Mattkomi/IHM_CNC/Besoin.xlsx

Sheet: Feuil1
Nom | Quantité | Coût | Fabricant | Numéro | Lien
Relai | 8 |  | American Zettler | AZ943-1CH-12DE | https://www.digikey.ca/fr/products/detail/american-zettler/AZ943-1CH-12DE/12171590
Relai double | 2 |  | American Zettler | AZ733-2CE-12DE | https://www.digikey.ca/fr/products/detail/american-zettler/AZ733-2CE-12DE/14307609
LED Blanche | 4 |  | QT Brightek (QTB) | QBL8IW40D-CW | https://www.digikey.ca/fr/products/detail/qt-brightek-qtb/QBL8IW40D-CW/10441179
LED RGB | 6 |  | QT Brightek (QTB) | QBL8RGB60D0-2897 | https://www.digikey.ca/fr/products/detail/qt-brightek-qtb/QBL8RGB60D0-2897/10441184
Switch | 8 |  | E-Switch | RB141C1100 | https://www.digikey.ca/fr/products/detail/e-switch/RB141C1100/3778081
Buzzer | 1 |  | Soberton Inc. | WT-1205 | https://www.digikey.ca/fr/products/detail/soberton-inc/WT-1205/479674
ESP32 | 1 |  | Espressif Systems | ESP32-DEVKITM-1 | https://www.digikey.ca/fr/products/detail/espressif-systems/ESP32-DEVKITM-1/13532113
Régulateur tension | 1 |  | Texas Instruments | LM2596S-5.0 | https://www.digikey.ca/fr/products/detail/texas-instruments/lm2596s-5-0/3701226
Ventilateur | 1 |  | Sunon Fans | HA40201V4-1000U-A99 | https://www.digikey.ca/fr/products/detail/sunon-fans/HA40201V4-1000U-A99/6198729
Capteur de flamme | 1 |  | Soldered Electronics | 333047 | https://www.digikey.ca/fr/products/detail/soldered-electronics/333047/21720425
Capteur de température Water | 2 |  | DFRobot | DFR0198 | https://www.digikey.ca/fr/products/detail/dfrobot/DFR0198/7597054
Capteur de température | 1 |  | Analog Devices Inc. | TMP36GT9Z | https://www.digikey.ca/fr/products/detail/analog-devices-inc/TMP36GT9Z/820404
Transistor | 15 |  | Diotec Semiconductor | BC337-16 | https://www.digikey.ca/fr/products/detail/diotec-semiconductor/BC337-16/22191949
Connecteur Embase | 3 |  | Harwin Inc. | M20-7822046 | https://www.digikey.ca/fr/products/detail/harwin-inc/m20-7822046/3727872
Switch Alimentation | 1 |  | E-Switch | RA1113112R | https://www.digikey.ca/fr/products/detail/e-switch/RA1113112R/3778055
Capteur humidité + température | 1 |  | Seeed Technology Co., Ltd | 101020011 | https://www.digikey.ca/fr/products/detail/seeed-technology-co-ltd/101020011/5482602
Ecran OLED | 1 |  | Newhaven Display Intl | NHD-2.7-12864WDW3 | https://www.digikey.ca/fr/products/detail/newhaven-display-intl/nhd-2-7-12864wdw3/7355953
Extender GPIO | 5 |  | Microchip Technology | MCP23017-E/SO | https://www.digikey.ca/fr/products/detail/microchip-technology/mcp23017-e-so/894271
Extender GPIO | 5 |  | NXP USA Inc. | PCA9685PW,112 | https://www.digikey.ca/fr/products/detail/nxp-usa-inc/pca9685pw-112/2034324
Level Shifter | 3 |  | Texas Instruments | TXS0104ED | https://www.digikey.ca/fr/products/detail/texas-instruments/txs0104ed/1910175
Conn JST DROIT Male 2pin | 16 |  | JST Sales America Inc. | B2B-XH-A | https://www.digikey.ca/fr/products/detail/jst-sales-america-inc/B2B-XH-A/1651045
Conn JST 90deg male 2pin | 3 |  | JST Sales America Inc. | S2B-XH-A-1 | https://www.digikey.ca/fr/products/detail/jst-sales-america-inc/S2B-XH-A-1/9961922
Conn JST femelle 2pin | 20 |  | JST Sales America Inc. | XHP-2 | https://www.digikey.ca/fr/products/detail/jst-sales-america-inc/XHP-2/555485
Conn JST Male 20pin | 2 |  | JST Sales America Inc. | B20B-XH-A(LF)(SN) | https://www.digikey.ca/fr/products/detail/jst-sales-america-inc/B20B-XH-A-LF-SN/3677009
Conn JST Femelle 20pin | 2 |  | JST Sales America Inc. | XHP-20 | https://www.digikey.ca/fr/products/detail/jst-sales-america-inc/XHP-20/1651009
Conn JST 90deg male 3pin | 6 |  | JST Sales America Inc. | S3B-XH-A | https://www.digikey.ca/fr/products/detail/jst-sales-america-inc/S3B-XH-A/1651048
Conn JST femelle 3pin | 10 |  | JST Sales America Inc. | XHP-3 | https://www.digikey.ca/fr/products/detail/jst-sales-america-inc/XHP-3/1651017
Conn JST male 4pin | 6 |  | JST Sales America Inc. | B4B-XH-A | https://www.digikey.ca/fr/products/detail/jst-sales-america-inc/B4B-XH-A/1651047
Conn JST femelle 4pin | 10 |  | JST Sales America Inc. | XHP-4 | https://www.digikey.ca/fr/products/detail/jst-sales-america-inc/xhp-4/683353
Contact JST XH | 100 |  | JST Sales America Inc. | SXH-002T-P0.6 | https://www.digikey.ca/fr/products/detail/jst-sales-america-inc/SXH-002T-P0-6/1651063
Conn Molex Male 2pin | 10 |  | Molex | 430450200 | https://www.digikey.ca/fr/products/detail/molex/0430450200/252526
Conn Molex femelle 2pin | 10 |  | Molex | 430250200 | https://www.digikey.ca/fr/products/detail/molex/0430250200/252496
Contact Molex microfit | 100 |  | Molex | 430300038 | https://www.digikey.ca/fr/products/detail/molex/0430300038/6098601
Resistance 10k Ohm CMS | 10 |  | YAGEO | RC1206FR-0710KL | https://www.digikey.ca/fr/products/detail/yageo/RC1206FR-0710KL/728483
Resistance 1,6k Ohm CMS | 10 |  | YAGEO | RC1206FR-071K6L | https://www.digikey.ca/fr/products/detail/yageo/RC1206FR-071K6L/728450
Resistance 1,3k Ohm CMS | 10 |  | YAGEO | RC1206FR-071K3L | https://www.digikey.ca/fr/products/detail/yageo/RC1206FR-071K3L/728423
Resistance 1k Ohm CMS | 10 |  | YAGEO | RC1206FR-071KL | https://www.digikey.ca/fr/products/detail/yageo/RC1206FR-071KL/728387
Resistance 4,7k Ohm CMS | 10 |  | YAGEO | RC1206FR-074K7L | https://www.digikey.ca/fr/products/detail/yageo/RC1206FR-074K7L/728887
Resistance 680 Ohm CMS | 15 |  | YAGEO | RC1206FR-07680RL | https://www.digikey.ca/fr/products/detail/yageo/RC1206FR-07680RL/729064
Resistance 330 Ohm CMS | 10 |  | YAGEO | RC1206FR-07330RL | https://www.digikey.ca/fr/products/detail/yageo/RC1206FR-07330RL/728822
Resistance 220 Ohm CMS | 10 |  | YAGEO | RC1206FR-07220RL | https://www.digikey.ca/fr/products/detail/yageo/RC1206FR-07220RL/728693
Resistance 120 Ohm CMS | 15 |  | YAGEO | RC1206FR-07120RL | https://www.digikey.ca/fr/products/detail/yageo/RC1206FR-07120RL/728523
Diode shockty | 15 |  | Diotec Semiconductor | 1N5821 | https://www.digikey.ca/fr/products/detail/diotec-semiconductor/1N5821/22193451
Condensateur 150µF | 2 |  | Panasonic Electronic Components | EEU-FR1E151 | https://www.digikey.ca/fr/products/detail/panasonic-electronic-components/EEU-FR1E151/2433548
Condensateur 330µF | 2 |  | Panasonic Electronic Components | EEU-FR1E331 | https://www.digikey.ca/fr/products/detail/panasonic-electronic-components/eeu-fr1e331/2433549
Inductance 68µH | 2 |  | Bourns Inc. | SRR1260-680M | https://www.digikey.ca/fr/products/detail/bourns-inc/SRR1260-680M/1969964
Condensateur 100nF | 10 |  | EPCOS - TDK Electronics | B32529C0104J289 | https://www.digikey.ca/fr/products/detail/epcos-tdk-electronics/B32529C0104J289/1089744
SW AU | 1 |  | APEM Inc. | YW1B-V4E01R | https://www.digikey.ca/fr/products/detail/apem-inc/YW1B-V4E01R/15216547
Alimentation | 1 |  | Qualtek | QFWB-36-12-US01 | https://www.digikey.ca/fr/products/detail/qualtek/QFWB-36-12-US01/8260131
Conn ALIM | 1 |  | MPD (Memory Protection Devices) | EJ502A | https://www.digikey.ca/fr/products/detail/mpd-memory-protection-devices/EJ502A/2439536
Ventilateur | 1 |  | Sunon Fans | MEC0251V3-000U-A99 | https://www.digikey.ca/fr/products/detail/sunon-fans/MEC0251V3-000U-A99/2021100
Tresse à dessouder | 1 |  | Techspray | 1811-5F | https://www.digikey.ca/fr/products/detail/techspray/1811-5F/7914502
FLUX | 1 |  | Chip Quik Inc. | NC191 | https://www.digikey.ca/fr/products/detail/chip-quik-inc/NC191/11480391
Etain | 1 |  | American Hakko Products, Inc. | 611-1 | https://www.digikey.ca/fr/products/detail/american-hakko-products-inc/611-1/6228764
Buzzer | 1 |  | Mallory Sonalert Products Inc. | PK-26N04W-03VQ | https://www.digikey.ca/fr/products/detail/mallory-sonalert-products-inc/PK-26N04W-03VQ/5033696

Sheet: Feuil2
Pompe
Tuyau
Petite grille
Seau / bac
Entretoise
insert
