Mattkomi/IHM_CNC/CAO/IHM_P1 v14.stl

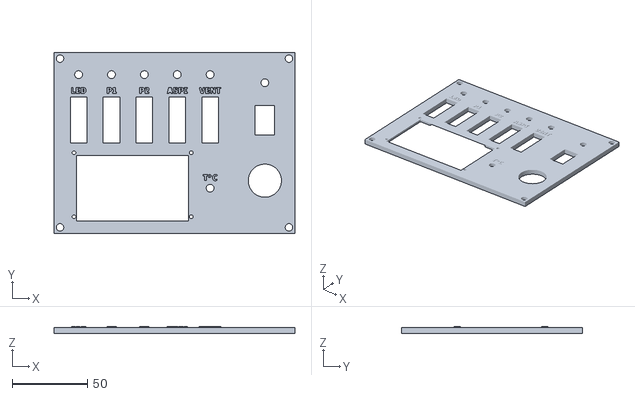
[picture p1: CAD file, 2025-04-13]
CAO/IHM_P1 v14.stl
160.0 x 120.0 x 4.50
