Mattkomi/IHM_CNC/PCB_control/PCB_control.kicad_pcb

## KiCad design PCB_control/PCB_control.kicad_pcb (2025-04-13)

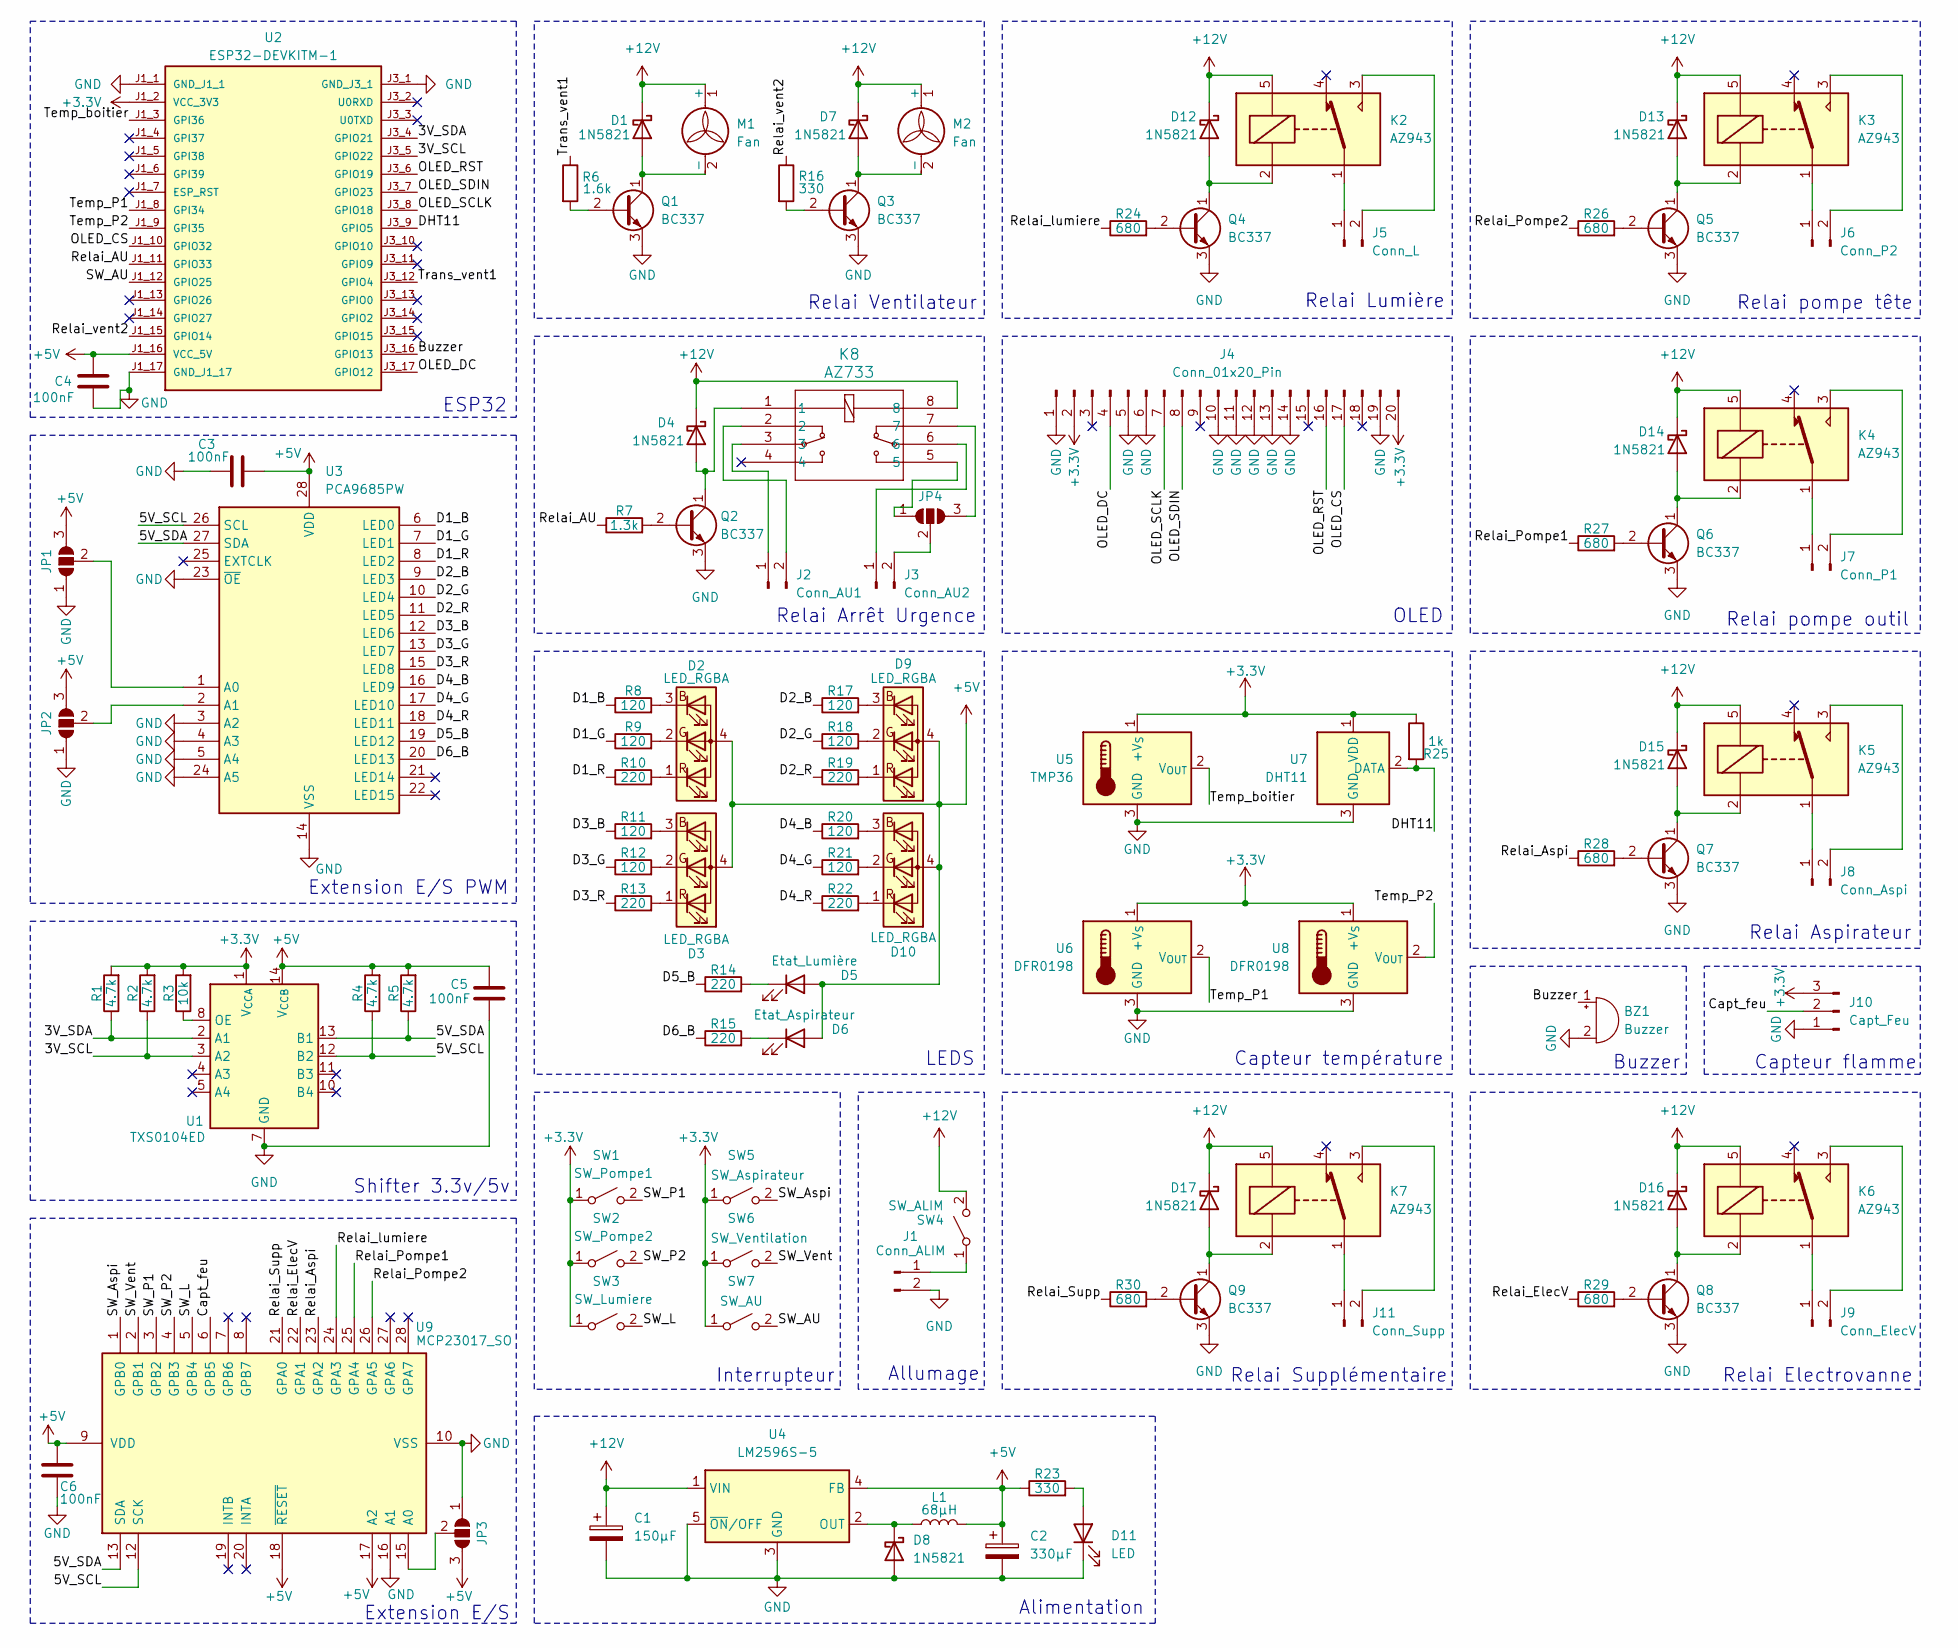
[picture p2: schematic PCB_control.kicad_sch, Schéma éléctronique IHM CNC]

Parts:
BZ1: Buzzer; WST-1205S
C1: 150µF; CP_Radial_D6.3mm_P2.50mm
C2: 330µF; CP_Radial_D8.0mm_P3.50mm
C3, C4, C5, C6: 100nF; CAP_R82D-7P4X2P6-5P0_KEM
D1, D4, D7, D8, D12, D13, D14, D15, D16, D17: 1N5821; P2_DO-201
D2, D3, D9, D10: LED_RGBA; JST_XH_B4B-XH-A_1x04_P2.50mm_Vertical
D5: Etat_Lumière; JST_XH_B2B-XH-A_1x02_P2.50mm_Vertical
D6: Etat_Aspirateur; JST_XH_B2B-XH-A_1x02_P2.50mm_Vertical
D11: LED; JST_XH_B2B-XH-A_1x02_P2.50mm_Vertical
J1: Conn_ALIM; JST_XH_B2B-XH-A_1x02_P2.50mm_Vertical
J2: Conn_AU1; Molex_Micro-Fit_3.0_43045-0200_2x01_P3.00mm_Horizontal
J3: Conn_AU2; Molex_Micro-Fit_3.0_43045-0200_2x01_P3.00mm_Horizontal
J4: Conn_01x20_Pin; JST_XH_B20B-XH-A_1x20_P2.50mm_Vertical
J5: Conn_L; Molex_Micro-Fit_3.0_43045-0200_2x01_P3.00mm_Horizontal
J6: Conn_P2; Molex_Micro-Fit_3.0_43045-0200_2x01_P3.00mm_Horizontal
J7: Conn_P1; Molex_Micro-Fit_3.0_43045-0200_2x01_P3.00mm_Horizontal
J8: Conn_Aspi; Molex_Micro-Fit_3.0_43045-0200_2x01_P3.00mm_Horizontal
J9: Conn_ElecV; Molex_Micro-Fit_3.0_43045-0200_2x01_P3.00mm_Horizontal
J10: Capt_Feu; JST_XH_S3B-XH-A_1x03_P2.50mm_Horizontal
J11: Conn_Supp; Molex_Micro-Fit_3.0_43045-0200_2x01_P3.00mm_Horizontal
JP1, JP2, JP3: SolderJumper_3_Open; SolderJumper-3_P1.3mm_Open_RoundedPad1.0x1.5mm
JP4: SolderJumper_3_Open; SolderJumper-3_P1.3mm_Open_RoundedPad1.0x1.5mm_NumberLabels
K2, K3, K4, K5, K6, K7: AZ943; AZ943-1CH_AMZ
K8: AZ733; AZ733-2C_AMZ
L1: 68µH; L_Bourns_SRR1260
M1: Fan; JST_XH_B2B-XH-A_1x02_P2.50mm_Vertical
M2: Fan; JST_XH_S2B-XH-A-1_1x02_P2.50mm_Horizontal
Q1, Q2, Q3, Q4, Q5, Q6, Q7, Q8, Q9: BC337; TO-92_Inline
R1, R2, R4, R5: 4.7k; R_1206_3216Metric_Pad1.30x1.75mm_HandSolder
R3: 10k; R_1206_3216Metric_Pad1.30x1.75mm_HandSolder
R6: 1.6k; R_1206_3216Metric_Pad1.30x1.75mm_HandSolder
R7: 1.3k; R_1206_3216Metric_Pad1.30x1.75mm_HandSolder
R8, R9, R11, R12, R17, R18, R20, R21: 120; R_1206_3216Metric_Pad1.30x1.75mm_HandSolder
R10, R13, R14, R15, R19, R22: 220; R_1206_3216Metric_Pad1.30x1.75mm_HandSolder
R16, R23: 330; R_1206_3216Metric_Pad1.30x1.75mm_HandSolder
R24, R26, R27, R28, R29, R30: 680; R_1206_3216Metric_Pad1.30x1.75mm_HandSolder
R25: 1k; R_1206_3216Metric_Pad1.30x1.75mm_HandSolder
SW1: SW_Pompe1; JST_XH_B2B-XH-A_1x02_P2.50mm_Vertical
SW2: SW_Pompe2; JST_XH_B2B-XH-A_1x02_P2.50mm_Vertical
SW3: SW_Lumiere; JST_XH_B2B-XH-A_1x02_P2.50mm_Vertical
SW4: SW_ALIM; JST_XH_B2B-XH-A_1x02_P2.50mm_Vertical
SW5: SW_Aspirateur; JST_XH_B2B-XH-A_1x02_P2.50mm_Vertical
SW6: SW_Ventilation; JST_XH_B2B-XH-A_1x02_P2.50mm_Vertical
SW7: SW_AU; JST_XH_B2B-XH-A_1x02_P2.50mm_Vertical
U1: TXS0104ED; SOIC-14_3.9x8.7mm_P1.27mm
U2: ESP32-DEVKITM-1; MODULE_ESP32-DEVKITM-1; PARTREV 1.0
U3: PCA9685PW; TSSOP-28_4.4x9.7mm_P0.65mm
U4: LM2596S-5; TO-263-5_TabPin3
U5: TMP36; TO-92_Inline
U6, U8: DFR0198; JST_XH_S3B-XH-A_1x03_P2.50mm_Horizontal
U7: DHT11; JST_XH_S3B-XH-A_1x03_P2.50mm_Horizontal
U9: MCP23017_SO; TSSOP-28_4.4x9.7mm_P0.65mm

Connections:
+3.3V: J4.2, J4.20, J10.3, R1.2, R2.2, R3.2, R25.1, SW1.1 (A), SW2.1 (A), SW3.1 (A), SW5.1 (A), SW6.1 (A), SW7.1 (A), U1.1 (V_{CCA}), U2.J1_2 (VCC_3V3), U5.1 (+V_{S}), U6.1 (+V_{S}), U7.1 (VDD), U8.1 (+V_{S})
+5V: C2.1, C3.2, C4.1, C5.1, C6.1, D2.4 (A), D3.4 (A), D5.2 (A), D6.2 (A), D9.4 (A), D10.4 (A), JP1.3 (B), JP2.3 (B), JP3.3 (B), L1.2, R4.2, R5.2, R23.1, U1.14 (V_{CCB}), U2.J1_16 (VCC_5V), U3.28 (VDD), U4.4 (FB), U9.9 (VDD), U9.17 (A2), U9.18 (~RESET)
+12V: C1.1, D1.1 (K), D4.1 (K), D7.1 (K), D12.1 (K), D13.1 (K), D14.1 (K), D15.1 (K), D16.1 (K), D17.1 (K), K2.5, K3.5, K4.5, K5.5, K6.5, K7.5, K8.8, M1.1 (+), M2.1 (+), SW4.2 (B), U4.1 (VIN)
/3V_SCL: R2.1, U1.3 (A2), U2.J3_5 (GPIO22)
/3V_SDA: R1.1, U1.2 (A1), U2.J3_4 (GPIO21)
/5V_SCL: R4.1, U1.12 (B2), U3.26 (SCL), U9.12 (SCK)
/5V_SDA: R5.1, U1.13 (B1), U3.27 (SDA), U9.13 (SDA)
/Buzzer: BZ1.1 (+), U2.J3_16 (GPIO13)
/Capt_feu: J10.2, U9.6 (GPB5)
/D1_B: R8.1, U3.6 (LED0)
/D1_G: R9.1, U3.7 (LED1)
/D1_R: R10.1, U3.8 (LED2)
/D2_B: R17.1, U3.9 (LED3)
/D2_G: R18.1, U3.10 (LED4)
/D2_R: R19.1, U3.11 (LED5)
/D3_B: R11.1, U3.12 (LED6)
/D3_G: R12.1, U3.13 (LED7)
/D3_R: R13.1, U3.15 (LED8)
/D4_B: R20.1, U3.16 (LED9)
/D4_G: R21.1, U3.17 (LED10)
/D4_R: R22.1, U3.18 (LED11)
/D5_B: R14.1, U3.19 (LED12)
/D6_B: R15.1, U3.20 (LED13)
/DHT11: R25.2, U2.J3_9 (GPIO5), U7.2 (DATA)
/OLED_CS: J4.17, U2.J1_10 (GPIO32)
/OLED_DC: J4.4, U2.J3_17 (GPIO12)
/OLED_RST: J4.16, U2.J3_6 (GPIO19)
/OLED_SCLK: J4.7, U2.J3_8 (GPIO18)
/OLED_SDIN: J4.8, U2.J3_7 (GPIO23)
/Relai_AU: R7.1, U2.J1_11 (GPIO33)
/Relai_Aspi: R28.1, U9.23 (GPA2)
/Relai_ElecV: R29.1, U9.22 (GPA1)
/Relai_Pompe1: R27.1, U9.25 (GPA4)
/Relai_Pompe2: R26.1, U9.26 (GPA5)
/Relai_Supp: R30.1, U9.21 (GPA0)
/Relai_lumiere: R24.1, U9.24 (GPA3)
/Relai_vent2: R16.1, U2.J1_15 (GPIO14)
/SW_AU: SW7.2 (B), U2.J1_12 (GPIO25)
/SW_Aspi: SW5.2 (B), U9.1 (GPB0)
/SW_L: SW3.2 (B), U9.5 (GPB4)
/SW_P1: SW1.2 (B), U9.3 (GPB2)
/SW_P2: SW2.2 (B), U9.4 (GPB3)
/SW_Vent: SW6.2 (B), U9.2 (GPB1)
/Temp_P1: U2.J1_8 (GPI34), U6.2 (V_{OUT})
/Temp_P2: U2.J1_9 (GPI35), U8.2 (V_{OUT})
/Temp_boitier: U2.J1_3 (GPI36), U5.2 (V_{OUT})
/Trans_vent1: R6.1, U2.J3_12 (GPIO4)
GND: BZ1.2 (-), C1.2, C2.2, C3.1, C4.2, C5.2, C6.2, D8.2 (A), D11.1 (K), J1.2, J4.1, J4.5, J4.6, J4.10, J4.11, J4.12, J4.13, J4.14, J4.19, J10.1, JP1.1 (A), JP2.1 (A), JP3.1 (A), Q1.3 (E), Q2.3 (E), Q3.3 (E), Q4.3 (E), Q5.3 (E), Q6.3 (E), Q7.3 (E), Q8.3 (E), Q9.3 (E), U1.7 (GND), U2.J1_1 (GND_J1_1), U2.J1_17 (GND_J1_17), U2.J3_1 (GND_J3_1), U3.3 (A2), U3.4 (A3), U3.5 (A4), U3.14 (VSS), U3.23 (~OE), U3.24 (A5), U4.3 (GND), U4.5 (~ON/OFF), U5.3 (GND), U6.3 (GND), U7.3 (GND), U8.3 (GND), U9.10 (VSS), U9.16 (A1)
unnamed: D1.2 (A), M1.2 (-), Q1.1 (C)
unnamed: D2.3 (BK), R8.2
unnamed: D2.2 (GK), R9.2
unnamed: D2.1 (RK), R10.2
unnamed: D3.3 (BK), R11.2
unnamed: D3.2 (GK), R12.2
unnamed: D3.1 (RK), R13.2
unnamed: D4.2 (A), K8.1, Q2.1 (C)
unnamed: D5.1 (K), R14.2
unnamed: D6.1 (K), R15.2
unnamed: D7.2 (A), M2.2 (-), Q3.1 (C)
unnamed: D8.1 (K), L1.1, U4.2 (OUT)
unnamed: D9.3 (BK), R17.2
unnamed: D9.2 (GK), R18.2
unnamed: D9.1 (RK), R19.2
unnamed: D10.3 (BK), R20.2
unnamed: D10.2 (GK), R21.2
unnamed: D10.1 (RK), R22.2
unnamed: D11.2 (A), R23.2
unnamed: D12.2 (A), K2.2, Q4.1 (C)
unnamed: D13.2 (A), K3.2, Q5.1 (C)
unnamed: D14.2 (A), K4.2, Q6.1 (C)
unnamed: D15.2 (A), K5.2, Q7.1 (C)
unnamed: D16.2 (A), K6.2, Q8.1 (C)
unnamed: D17.2 (A), K7.2, Q9.1 (C)
unnamed: J1.1, SW4.1 (A)
unnamed: J2.1, K8.3
unnamed: J2.2, K8.2
unnamed: J3.1, K8.6
unnamed: J3.2, JP4.2 (C)
unnamed: J5.1, K2.1
unnamed: J5.2, K2.3
unnamed: J6.1, K3.1
unnamed: J6.2, K3.3
unnamed: J7.1, K4.1
unnamed: J7.2, K4.3
unnamed: J8.1, K5.1
unnamed: J8.2, K5.3
unnamed: J9.1, K6.1
unnamed: J9.2, K6.3
unnamed: J11.1, K7.1
unnamed: J11.2, K7.3
unnamed: JP1.2 (C), U3.1 (A0)
unnamed: JP2.2 (C), U3.2 (A1)
unnamed: JP3.2 (C), U9.15 (A0)
unnamed: JP4.1 (A), K8.5
unnamed: JP4.3 (B), K8.7
unnamed: Q1.2 (B), R6.2
unnamed: Q2.2 (B), R7.2
unnamed: Q3.2 (B), R16.2
unnamed: Q4.2 (B), R24.2
unnamed: Q5.2 (B), R26.2
unnamed: Q6.2 (B), R27.2
unnamed: Q7.2 (B), R28.2
unnamed: Q8.2 (B), R29.2
unnamed: Q9.2 (B), R30.2
unnamed: R3.1, U1.8 (OE)

Notes on the sheet:
Relai Lumière
Capteur température
Relai Supplémentaire
Shifter 3.3v/5v
Alimentation
Buzzer
ESP32
Capteur flamme
LEDS
Relai Ventilateur
Relai Electrovanne
Relai Arrêt Urgence
Extension E/S PWM
Relai pompe tête
Relai Aspirateur
Extension E/S
Allumage
Relai pompe outil
Interrupteur
OLED

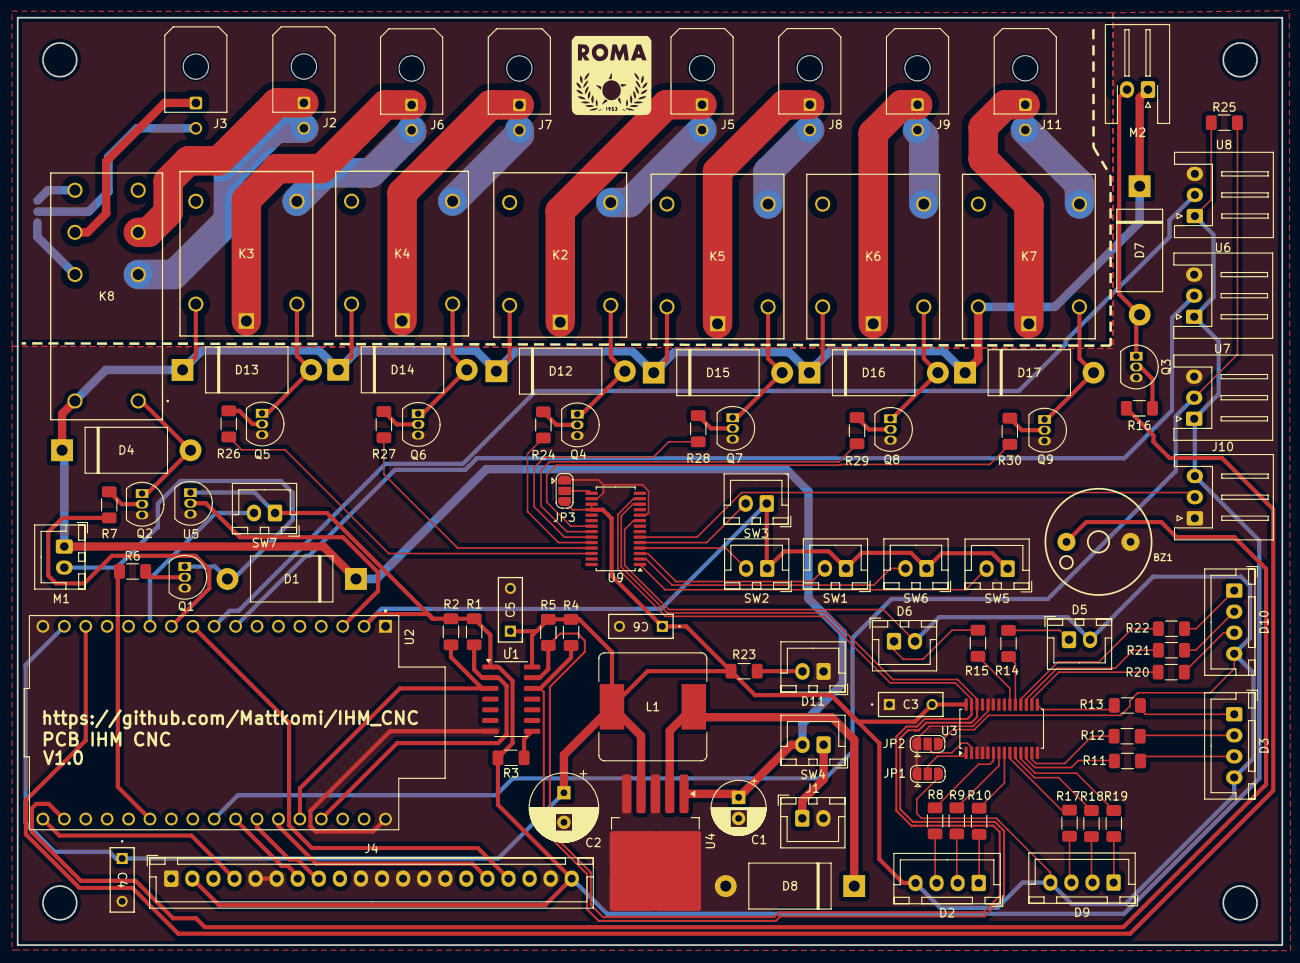
[picture p3: board PCB_control.kicad_pcb from above]

Board: 2 copper layers, 150.0 x 110.0 mm, 104 parts (1 on the bottom side), 105 nets.
